JoshDumo/OpticalMachines/Polarimeter/Mechanical/PXL_20250413_103746598.jpg

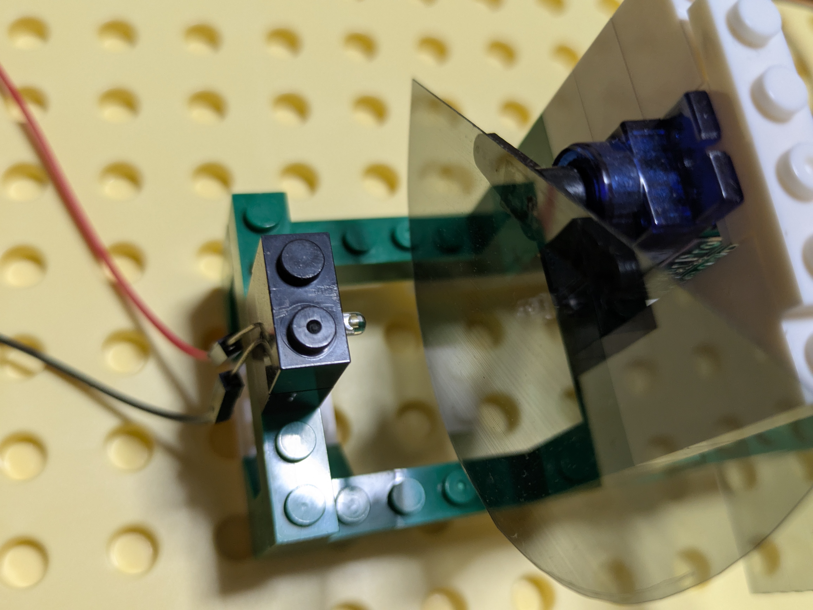
Polarimeter/Mechanical/PXL_20250413_103746598.jpg
