JoshDumo/OpticalMachines/Polarimeter/Mechanical/PXL_20250413_103715098.jpg

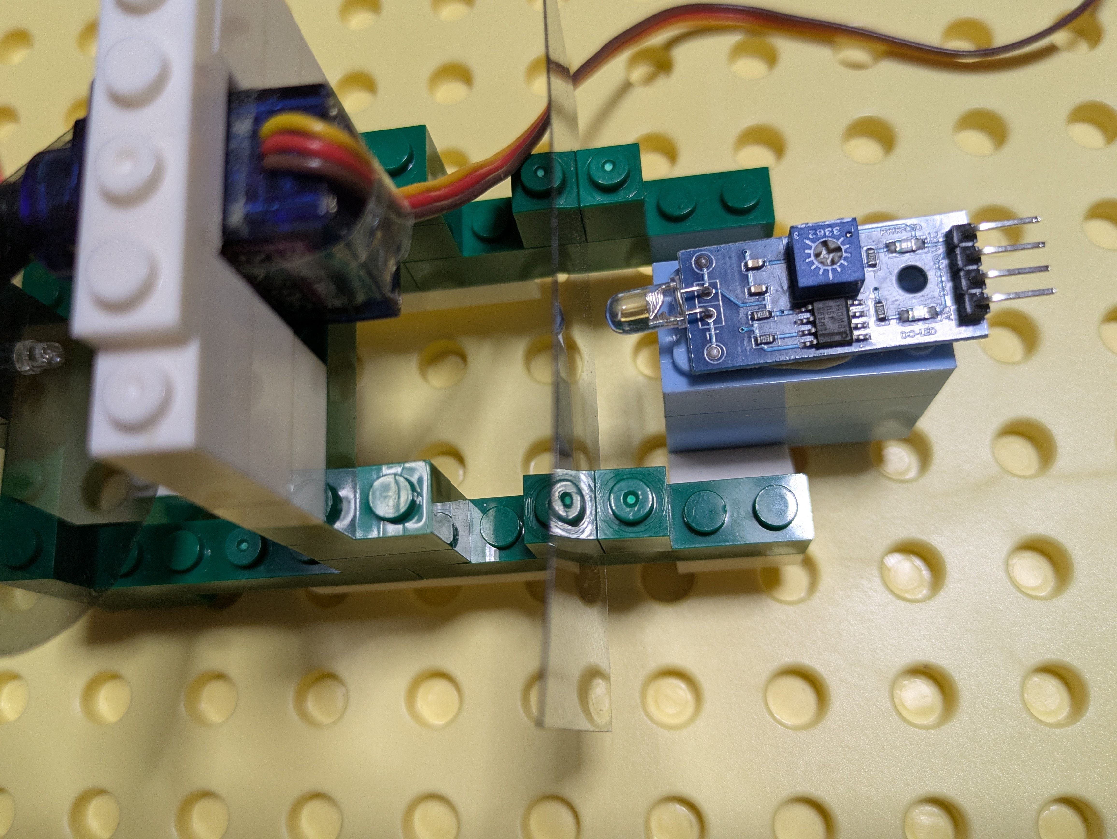
Polarimeter/Mechanical/PXL_20250413_103715098.jpg
