JoshDumo/OpticalMachines/README.md

# OpticalMachines
All kinds of computational machines that use light.

## Polarimeter
Build a simple Polarimeter model. There are some papers on how to build such a model, for teaching high school for example.
