JoshDumo/OpticalMachines/Polarimeter/Electronics/circuit.png

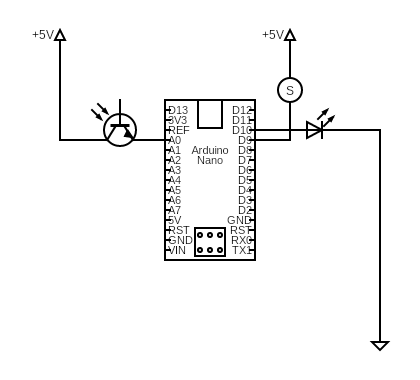
Polarimeter/Electronics/circuit.png
