JoshDumo/OpticalMachines/(threads)

Thread 2 (2025-04-13):

[Polarimeter] Build Mechanical Structure

JoshDumo, 2025-04-13:
Build the mechanical structure of the Polarimeter components:

- Base Frame,
- LED mount,
- Photodetector mount,
- Static Polarizer mount,
- Rotating Polarizer mount.

Closed 2025-04-14.
